Jhadeeee/Smart-Outlet-WebApp/README.md

# Smart-Outlet-WebApp
This is a web application project of smart outlet energy monitoring.
>>>>>>> 6da4d530e3375cbe3e670f05060c08142b17220a
