Jhadeeee/Smart-Outlet-WebApp/ISO25010_Questionnaire.pdf

# ISO 25010 Software Quality Evaluation Questionnaire

## Smart Outlet Web Application

## Home Appliances Load Monitoring System

### Based on ISO/IEC 25010:2023

### Systems and Software Quality Requirements and Evaluation (SQuaRE)

ISO 25010 Software Quality Evaluation - Smart Outlet Web Application

## Respondent Profile

Name (optional): | ___________________________________
Role: | End-User / Developer / IT Expert / Faculty-Evaluator
Age Range: | 18-25 / 26-35 / 36-45 / 46+
Technical Background: | Beginner / Intermediate / Advanced

## Rating Scale (5-Point Likert Scale)

Score | Interpretation

5 Strongly Agree

4 Agree

3 Neutral

2 Disagree

1 Strongly Disagree

## Part I: Product Quality (ISO 25010)

## 1. Functional Suitability

The degree to which the system provides functions that meet stated and implied needs.

# | Statement | 5 | 4 | 3 | 2 | 1

1.1 | The system accurately displays real-time current readings (mA) from smart outlets.
1.2 | The relay ON/OFF toggle controls work correctly and respond to user commands.
1.3 | The system correctly computes and displays the total load current from the main breaker sensor.
1.4 | The event history page allows users to view and filter past system events effectively.
1.5 | The system provides appropriate alerts/indicators for overload conditions.

## 2. Performance Efficiency

The performance relative to the amount of resources used under stated conditions.

# | Statement | 5 | 4 | 3 | 2 | 1

2.1 | The dashboard loads within an acceptable time (under 3 seconds).
2.2 | Real-time sensor data updates on the UI without noticeable delay.
2.3 | The live load history chart renders smoothly without lag.
2.4 | The system performs well even when multiple outlets are being monitored simultaneously.

## 3. Compatibility

The degree to which the system can exchange information with other systems and coexist in a shared environment.

# | Statement | 5 | 4 | 3 | 2 | 1

3.1 | The web application works correctly across different browsers (Chrome, Firefox, Edge, Safari).
3.2 | The system successfully communicates with the ESP32 (CCU) hardware over the local network.
3.3 | The Google Sheets integration exports data correctly and consistently.

## 4. Usability

The degree to which the system can be used by specified users to achieve goals effectively, efficiently, and with satisfaction.

# | Statement | 5 | 4 | 3 | 2 | 1

4.1 | The dashboard interface is visually appealing and easy to understand at first glance.
4.2 | Navigating between pages (Dashboard, Event History, AI Chatbot) is intuitive.
4.3 | The color-coded indicators (green, yellow, red) for load status are clear and informative.
4.4 | The expandable PIC cards make it easy to view and control individual outlet sockets.
4.5 | Error messages and toast notifications are clear and helpful.
4.6 | The system can be used with minimal training or prior technical knowledge.

## 5. Reliability

The degree to which the system performs specified functions under specified conditions for a specified period of time.

# | Statement | 5 | 4 | 3 | 2 | 1

5.1 | The system operates continuously without unexpected crashes or downtime.
5.2 | WebSocket connections for real-time updates reconnect automatically after disconnection.
5.3 | Sensor data is logged to the database reliably at the expected intervals.
5.4 | The system correctly recovers and displays the last known state when reopening a PIC card.

## 6. Security

The degree to which the system protects information and data from unauthorized access.

# | Statement | 5 | 4 | 3 | 2 | 1

6.1 | The login system effectively prevents unauthorized users from accessing the dashboard.
6.2 | User accounts and data are properly isolated (one user cannot access another's outlets).
6.3 | Sensitive actions (relay control, threshold setting) require authentication.
6.4 | The system uses secure communication protocols between the web app and hardware.

## 7. Maintainability

The degree of effectiveness and efficiency with which the system can be modified.

# | Statement | 5 | 4 | 3 | 2 | 1

7.1 | The codebase is well-organized and follows a clear project structure.
7.2 | New outlets or CCUs can be registered without modifying server code.
7.3 | The documentation is sufficient for a new developer to understand and maintain the project.

## 8. Portability

The degree to which the system can be transferred from one environment to another.

# | Statement | 5 | 4 | 3 | 2 | 1

8.1 | The web application is accessible from both desktop and mobile devices (responsive design).
8.2 | The system can be deployed on different hosting environments (local server, cloud).
8.3 | The application adapts properly to different screen sizes and orientations.

## Part II: Quality in Use (ISO 25010)

## 9. Effectiveness

Accuracy and completeness with which users achieve specified goals.

# | Statement | 5 | 4 | 3 | 2 | 1

9.1 | I was able to monitor my outlet power consumption accurately using the system.
9.2 | I was able to successfully control (turn on/off) outlet relays through the web interface.
9.3 | I was able to identify overload conditions and take appropriate action using the system.

## 10. Efficiency

Resources expended in relation to the accuracy and completeness of goals achieved.

# | Statement | 5 | 4 | 3 | 2 | 1

10.1 | I can complete common tasks (check status, toggle relays) quickly and with few steps.
10.2 | The system reduces the effort needed to monitor power usage compared to manual methods.

## 11. Satisfaction

The degree to which user needs are satisfied when using the system.

# | Statement | 5 | 4 | 3 | 2 | 1

11.1 | I am satisfied with the overall quality and appearance of the web application.
11.2 | I would recommend this system to others for home appliance load monitoring.
11.3 | The system meets my expectations for a smart outlet monitoring solution.

## 12. Safety / Freedom from Risk

The degree to which the system mitigates potential risk to users, property, or the environment.

# | Statement | 5 | 4 | 3 | 2 | 1

12.1 | The overload detection and alert system helps prevent potential electrical hazards.
12.2 | The "Cut All Power" emergency feature provides confidence in handling dangerous situations.
