Jhadeeee/Smart-Outlet-WebApp/Milestone/Central Control Unit dev/Documentation/CCU_Simulation_2.0.0.PDF

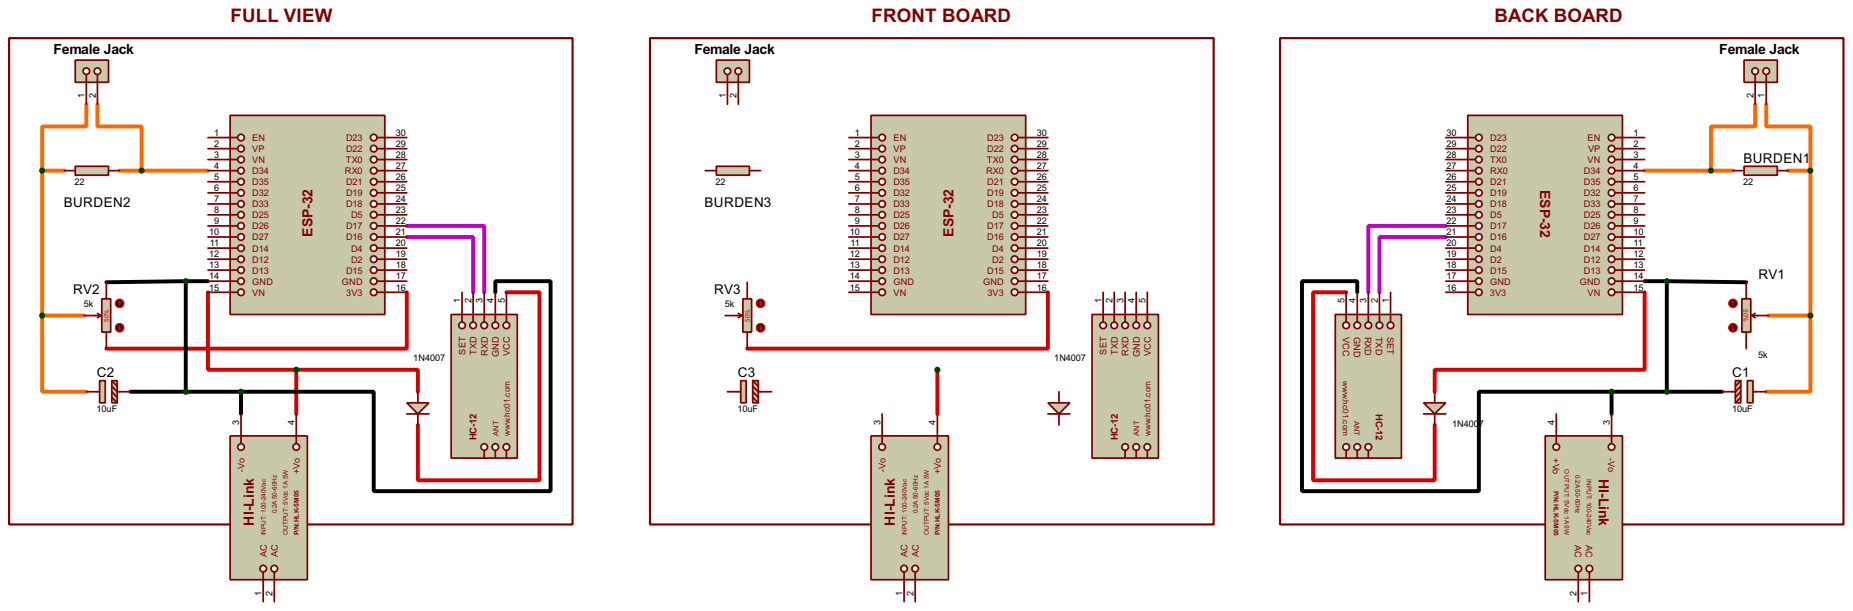
[picture p10: page 1]

ESP-32 ENVPVND35 D32 D33 D25 D26 D27 D14 D12 D13 GND VND34 D23 D22 TX0 RX0 D21 D19 D18D5 D17 D16D4D2 D15 GND 3V3 123456789101112131415 302928272625242322212019181716 HI-Link ACAC -Vo +Vo INPUT: 100-240Vac 0.2A 50-60Hz OUTPUT: 5Vdc 1A 5W P/N:HLK-5M05 12 34 SET TXD RXD GND VCC HC-12 ANT www.hc01.com 12345 BURDEN3 22 C3 10uF50% RV35k12 Female Jack FRONT BOARD 1N4007 ESP-32 ENVPVN D35 D32 D33 D25 D26 D27 D14 D12 D13 GNDVN D34 D23 D22 TX0 RX0 D21 D19 D18 D5D17 D16 D4D2D15 GND 3V3 123456789101112131415 302928272625242322212019181716 HI-Link ACAC -Vo +Vo INPUT: 100-240Vac 0.2A 50-60Hz OUTPUT: 5Vdc 1A 5W P/N:HLK-5M05 21 43 SET TXD RXD GND VCC HC-12 ANT www.hc01.com 54321 BURDEN1 22 C1 10uF50% RV1 5k 21 Female Jack BACK BOARD 1N4007 ESP-32 ENVPVND35 D32 D33 D25 D26 D27 D14 D12 D13 GND VND34 D23 D22 TX0 RX0 D21 D19 D18D5 D17 D16D4D2 D15 GND 3V3 123456789101112131415 302928272625242322212019181716 HI-Link ACAC -Vo +Vo INPUT: 100-240Vac 0.2A 50-60Hz OUTPUT: 5Vdc 1A 5W P/N:HLK-5M05 12 34 SET TXD RXD GND VCC HC-12 ANT www.hc01.com 12345 BURDEN2 22 C2 10uF50% RV25k12 Female Jack FULL VIEW 1N4007
