Jhadeeee/Smart-Outlet-WebApp/Milestone/Central Control Unit dev/Documentation/CCU_Simulation.PDF

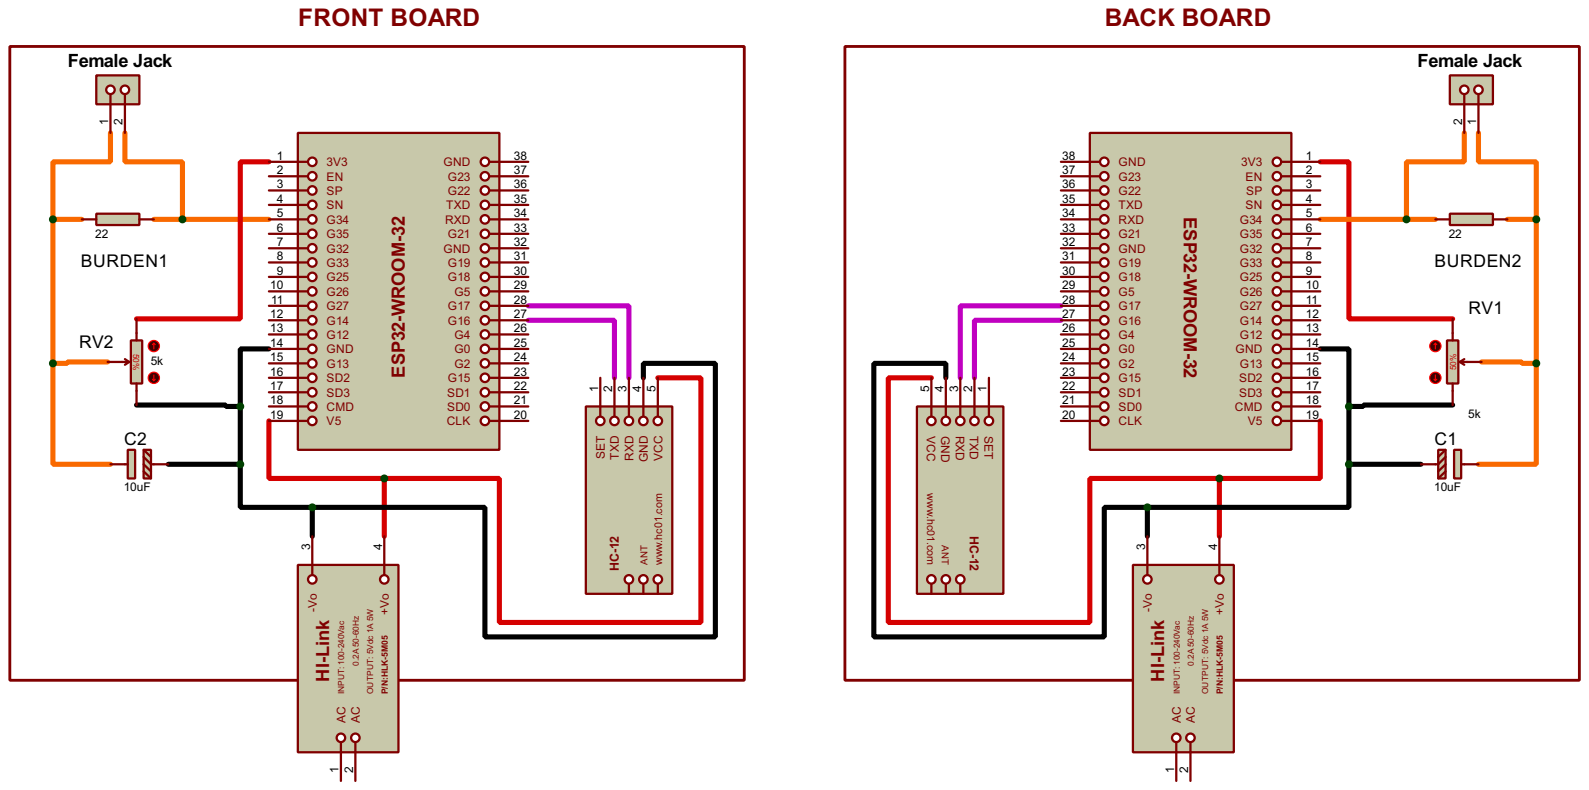
[picture p11: page 1]
