Jhadeeee/Smart-Outlet-WebApp/Milestone/Smart Outlet Device dev/Images/Smart outlet_Actual_Circuit_v5.2.0.PDF

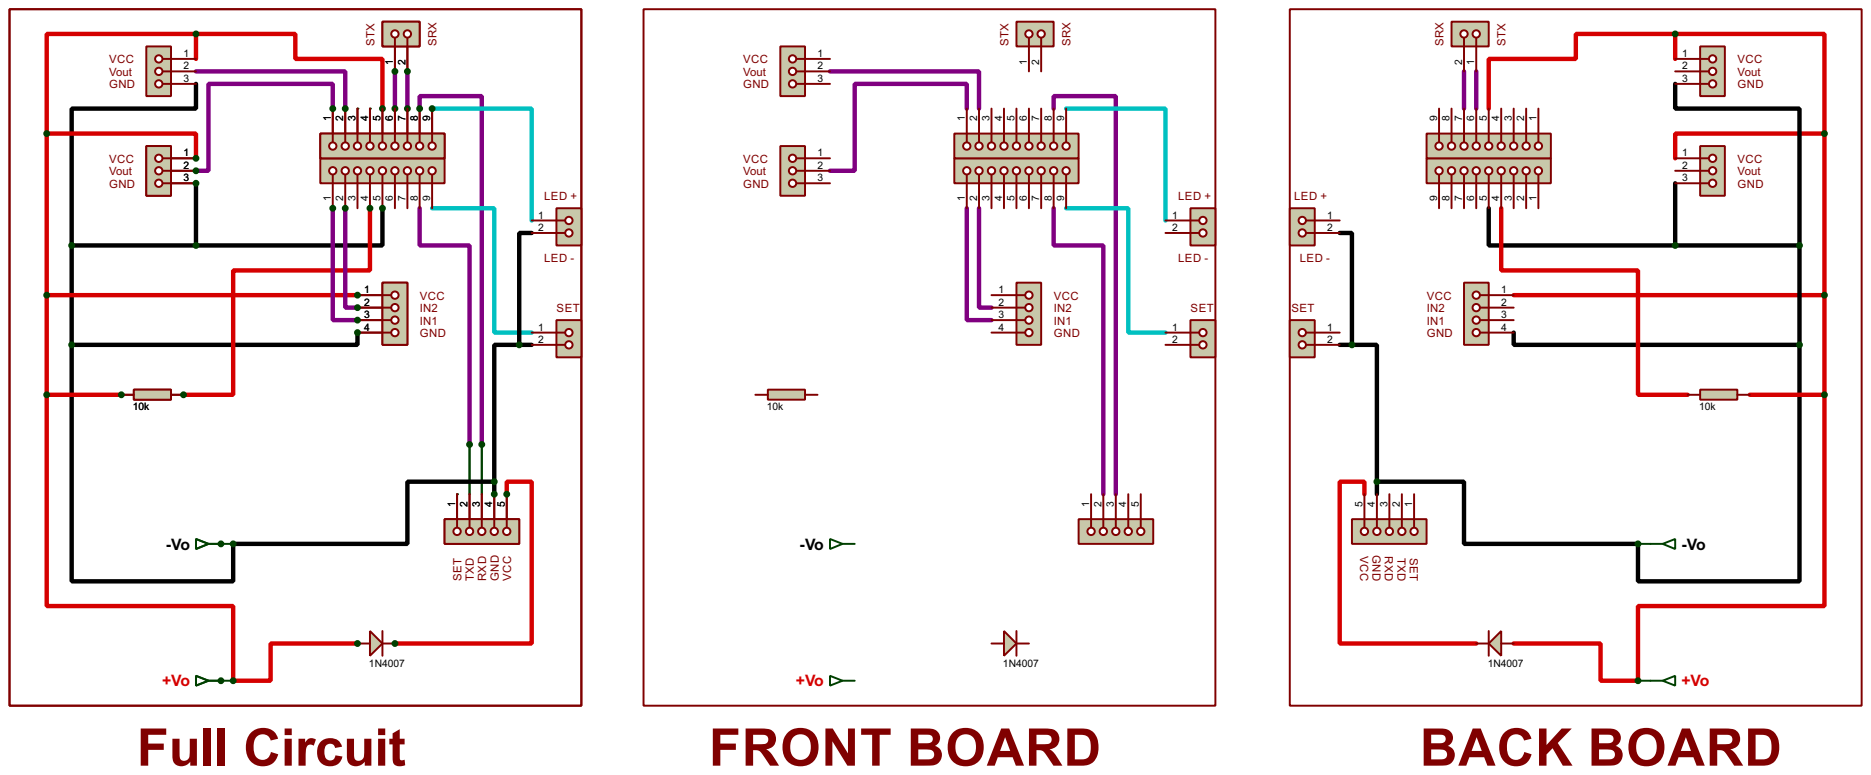
[picture p12: page 1]
