Jhadeeee/Smart-Outlet-WebApp/Central_Control_Unit_Firmware/Config.h

/*
 * Config.h
 * --------
 * Global configuration constants for the CCU Firmware v4.0.0.
 * Modify these values to match your hardware and preferences.
 */

#ifndef CONFIG_H
#define CONFIG_H

// ─── Access Point (Hotspot) Settings ────────────────────────
#define AP_SSID         "CCU-Setup"       // Name of the setup hotspot
#define AP_PASSWORD     ""                // Open network (no password)
#define AP_IP           IPAddress(192, 168, 4, 1)
#define AP_GATEWAY      IPAddress(192, 168, 4, 1)
#define AP_SUBNET       IPAddress(255, 255, 255, 0)

// ─── WiFi Connection Settings ───────────────────────────────
#define WIFI_CONNECT_TIMEOUT_MS   15000   // 15 seconds to attempt WiFi connection
#define WIFI_RETRY_DELAY_MS       500     // Delay between connection checks

// ─── Web Server ─────────────────────────────────────────────
#define WEB_SERVER_PORT  80

// ─── NVS Storage Keys ───────────────────────────────────────
#define NVS_NAMESPACE    "ccu-config"
#define NVS_KEY_SSID     "ssid"
#define NVS_KEY_PASSWORD "password"
#define NVS_KEY_SERVER   "serverUrl"

// ─── Hardware Pins ──────────────────────────────────────────
#define LED_PIN          2                // Built-in LED on most ESP32 boards
#define RESET_BTN_PIN    0                // BOOT button for factory reset

// ─── HC-12 RF Module ───────────────────────────────────────
#define HC12_RX_PIN      16               // ESP32 GPIO 16 ← HC-12 TX
#define HC12_TX_PIN      17               // ESP32 GPIO 17 → HC-12 RX
#define HC12_BAUD        9600             // HC-12 default baud rate

// ─── RF Protocol ────────────────────────────────────────────
#define RF_SOF           0xAA             // Start of Frame byte
#define RF_EOF           0xBB             // End of Frame byte
#define RF_PACKET_SIZE   8                // Fixed 8-byte packet size
#define CCU_SENDER_ID    0x02             // Non-default master ID — triggers LED on smart outlets
#define MAX_OUTLETS      8                // Maximum number of smart outlets

// ─── Breaker Monitor (SCT013) ───────────────────────────────
#define BREAKER_ADC_PIN              34   // ESP32 ADC pin (input-only, no pull-up)
#define BREAKER_CT_TURNS             2000 // SCT013-100 turns ratio
#define BREAKER_BURDEN_RESISTOR      23   // Burden resistor in Ohms
#define BREAKER_LINE_FREQ            60   // Mains frequency (50 or 60 Hz)
#define BREAKER_DEFAULT_THRESHOLD_MA 15000 // Default overload threshold (15A)
#define BREAKER_CLOUD_INTERVAL_MS    5000  // Send breaker data to cloud every 5s

// ─── Serial ─────────────────────────────────────────────────
#define SERIAL_BAUD      115200

// ─── Cloud / Server ─────────────────────────────────────────
#define CLOUD_SEND_INTERVAL_MS  2000      // How often to send data to server
#define HTTP_TIMEOUT_MS         5000      // HTTP request timeout
#define BACKGROUND_POLL_INTERVAL_MS  30000  // Poll non-focused outlets every 30s

#endif // CONFIG_H
