Jhadeeee/Smart-Outlet-WebApp/Central_Control_Unit_Firmware/src/WiFiServer/Cloud.cpp

/*
 * Cloud.cpp
 * ----------
 * Implementation of HTTP server communication.
 */

#include "Cloud.h"

Cloud::Cloud()
    : _serverUrl(""),
      _lastResponseCode(0),
      _lastResponse("") {}

void Cloud::begin(const String& serverUrl) {
    _serverUrl = serverUrl;

    // Ensure URL doesn't end with a trailing slash
    if (_serverUrl.endsWith("/")) {
        _serverUrl.remove(_serverUrl.length() - 1);
    }

    Serial.println("[Cloud] Initialized with server: " + _serverUrl);
}

int Cloud::sendSensorData(const String& jsonPayload) {
    if (_serverUrl.length() == 0 || WiFi.status() != WL_CONNECTED) {
        return -1;
    }

    HTTPClient http;
    String endpoint = _serverUrl + "/api/data/";
    
    http.begin(endpoint);
    http.addHeader("Content-Type", "application/json");
    http.setTimeout(HTTP_TIMEOUT_MS);

    _lastResponseCode = http.POST(jsonPayload);
    if (_lastResponseCode > 0) {
        _lastResponse = http.getString();
    } else {
        _lastResponse = http.errorToString(_lastResponseCode);
    }
    http.end();
    return _lastResponseCode;
}

int Cloud::sendBreakerData(const String& jsonPayload) {
    if (_serverUrl.length() == 0 || WiFi.status() != WL_CONNECTED) {
        return -1;
    }

    HTTPClient http;
    String endpoint = _serverUrl + "/api/breaker-data/";
    
    http.begin(endpoint);
    http.addHeader("Content-Type", "application/json");
    http.setTimeout(HTTP_TIMEOUT_MS);

    _lastResponseCode = http.POST(jsonPayload);
    if (_lastResponseCode > 0) {
        _lastResponse = http.getString();
    } else {
        _lastResponse = http.errorToString(_lastResponseCode);
    }
    http.end();
    return _lastResponseCode;
}

String Cloud::fetchCommands(const String& deviceId) {
    if (_serverUrl.length() == 0 || WiFi.status() != WL_CONNECTED) {
        return "";
    }

    HTTPClient http;
    String endpoint = _serverUrl + "/api/commands/" + deviceId + "/";
    
    http.begin(endpoint);
    http.setTimeout(HTTP_TIMEOUT_MS);

    _lastResponseCode = http.GET();
    String responseBody = "";
    
    if (_lastResponseCode == 200) {
        responseBody = http.getString();
    } else if (_lastResponseCode > 0) {
        _lastResponse = http.getString(); // Store error response
    } else {
        _lastResponse = http.errorToString(_lastResponseCode);
    }
    http.end();
    return responseBody;
}

String Cloud::fetchDevices() {
    if (_serverUrl.length() == 0 || WiFi.status() != WL_CONNECTED) {
        return "";
    }

    HTTPClient http;
    String endpoint = _serverUrl + "/api/devices/";
    
    http.begin(endpoint);
    http.setTimeout(HTTP_TIMEOUT_MS);

    _lastResponseCode = http.GET();
    String responseBody = "";
    
    if (_lastResponseCode == 200) {
        responseBody = http.getString();
    } else if (_lastResponseCode > 0) {
        _lastResponse = http.getString();
    } else {
        _lastResponse = http.errorToString(_lastResponseCode);
    }
    http.end();
    return responseBody;
}

String Cloud::fetchFocusDevice() {
    if (_serverUrl.length() == 0 || WiFi.status() != WL_CONNECTED) {
        return "";
    }

    HTTPClient http;
    String endpoint = _serverUrl + "/api/focus/";
    
    http.begin(endpoint);
    http.setTimeout(HTTP_TIMEOUT_MS);

    _lastResponseCode = http.GET();
    String responseBody = "";
    
    if (_lastResponseCode == 200) {
        responseBody = http.getString();
    } else if (_lastResponseCode > 0) {
        _lastResponse = http.getString();
    } else {
        _lastResponse = http.errorToString(_lastResponseCode);
    }
    http.end();
    return responseBody;
}

bool Cloud::isReachable() {
    if (_serverUrl.length() == 0 || WiFi.status() != WL_CONNECTED) {
        return false;
    }

    HTTPClient http;
    http.begin(_serverUrl);
    http.setTimeout(HTTP_TIMEOUT_MS);

    int code = http.GET();
    http.end();

    bool reachable = (code > 0);
    Serial.println("[Cloud] Server reachable: " + String(reachable ? "YES" : "NO"));
    return reachable;
}

String Cloud::getServerUrl() const       { return _serverUrl; }
int Cloud::getLastResponseCode() const   { return _lastResponseCode; }
String Cloud::getLastResponse() const    { return _lastResponse; }
