Jhadeeee/Smart-Outlet-WebApp/(commit log)

2026-02-22 feat: Add Smart Outlet firmware documentation, testing guide, ESP32 test sketch, and circuit diagram.
2026-02-23 chore: organize project workflow and restructure documentation
    - Add PROJECT_MILESTONES.md with system architecture, component status, and roadmap
    - Add CCU Firmware source code (ESP32 Arduino)
    - Add CCU developer documentation (FIRMWARE_DOCS.md, User_Testing_Guide.md)
    - Restructure Smart Outlet Device docs into Milestone/Documentation and Images folders
    - Fix broken documentation links in PROJECT_MILESTONES.md
    - Remove obsolete Smart Outlet firmware Documentation_v1.1.0 folder
    [CaptivePortal.cpp, CaptivePortal.h, Central_Control_Unit_Firmware.ino, Cloud.cpp, Cloud.h, Config.h, ConfigStorage.cpp, ConfigStorage.h]
2026-02-23 feat: Introduce firmware-aligned data models, API endpoints for sensor data and commands, and real-time WebSocket updates.
2026-02-23 feat: Establish firmware-to-web communication for sensor data and commands, and add web app user authentication and outlet control dashboard.
2026-02-23 feat: Implement core Central Control Unit firmware for current sensing and cloud communication, and establish Django models and API for smart outlet management.
2026-02-23 feat: Implement real-time sensor data and relay control via WebSockets, along with user authentication and dashboard views.
2026-02-24 feat: Implement core smart outlet backend with device API endpoints, data models, and web views.
2026-02-24 feat: complete testing dashboard UI and command queue API
    - Wired Set Limit and Cut Power buttons to fetch API
    - Replaced native confirm with Tailwind modals for reliability
    - Mapped SET_MASTER_ID event correctly in views.py
    - Updated milestone documentation for backend completion
    [Central_Control_Unit_Firmware.ino]
2026-02-24 feat: Adjust database schema by removing `SensorData` fields and manually creating the `PendingCommand` table, alongside adding database probing tools.
2026-02-24 feat: implement 2-way command polling on ESP32 CCU
    - Added fetch_pending_commands GET endpoint to Django views
    - Added fetchCommands() method to ESP32 Cloud library
    - CCU main loop now parses CMD_CUT_POWER, CMD_SET_LIMIT from JSON
    - Updated Verification Plan to include Captive Portal step
2026-02-24 Fix database schema for PendingCommand and ESP32 JSON casing
2026-02-24 Fix dashboard add device automatic DB insertion update
    [Central_Control_Unit_Firmware.ino, Cloud.cpp]
2026-02-24 Replace browser prompt with a Tailwind UI modal for adding devices
2026-02-25 feat: Implement core API endpoints for sensor data, breaker data, outlet status, and command queuing, alongside initial Central Control Unit firmware structure.
2026-02-25 docs: Add web app documentation, user setup guide, and update project milestones
    - Created WEBAPP_DOCS.md with architecture, models, API reference, data flow, WebSocket, and alert system
    - Created User_Setup_Guide.md with step-by-step setup, ESP32 connection, and troubleshooting
    - Updated PROJECT_MILESTONES.md: Web app status to v1.0.0 Stable, added 11 milestone entries
    - Updated roadmap: checked off cloud integration, dashboard, auto-registration, and alert system
    - Added documentation index links for both new docs
    - Fixed firmware: dynamic is_overload flag (was hardcoded false)
    - Fixed firmware: auto device registration from Django on boot and periodic re-sync
2026-02-25 Replace SCTSensor with BreakerMonitor (non-blocking)
    - Deleted src/SCTSensor/ — duplicate blocking sensor module
    - Restored BREAKER_* constants in Config.h (replaces SCT_* raw ADC approach)
    - Rewired main sketch to use BreakerMonitor (non-blocking update + getMilliAmps)
    - Fixed Dashboard constructor to pass BreakerMonitor reference
    - Added breakerMonitor.begin() in LOCAL_DASHBOARD and RUNNING mode entries
    - Added breakerMonitor.update() in both loop modes
    - Cloud push now uses breakerMonitor.getMilliAmps() instead of blocking readCurrentRMS()
    - Bumped firmware version to v4.0.0
    [Central_Control_Unit_Firmware.ino, Config.h]
2026-02-26 Updated Circuit diagram
2026-02-26 added .workspace on gitignore and updated circuit diagram
2026-02-26 Remove SCTSensor module — use BreakerMonitor exclusively
    - Deleted src/SCTSensor/ (blocking, redundant with BreakerMonitor)
    - Removed SCT_* derived constants from Config.h
    - Added BREAKER_CLOUD_INTERVAL_MS (5s breaker cloud push interval)
    - Jhade's .ino already uses BreakerMonitor correctly — no changes needed
    [Config.h]
2026-02-27 Fix overload logging, UI delay, and sensor data log interval
    - Moved breaker polling to an independent timer in firmware to eliminate total load current UI delay (Config.h, Central_Control_Unit_Firmware.ino)
    - Fixed firmware parser bug in OutletManager.cpp to correctly save and report 0xFFFF overload trips to the backend
    - Decreased DB_LOG_INTERVAL from 5 minutes to 30 seconds in api/views.py for faster history logging
    [Central_Control_Unit_Firmware.ino, Config.h, OutletManager.cpp]
2026-03-03 feat: Fix 65535mA display issue to OVERLOAD and set 1 minute every log of outlets_sensordata instead of 30s.
2026-03-03 Display current in mA instead of A (no rounding)
    - views.py: pass raw mA values instead of converting to Amps
    - home.html: show mA unit in static template and WebSocket updates
    - Subtitle shows total mA instead of rounded A
2026-03-03 Direct ESP32 communication + clean serial output
    - Django: Add ip_address, last_seen to CentralControlUnit model
    - Django: Add ccu FK to Outlet (auto-linked on sensor push)
    - Django: Add missing EventLog model (from Jhade merge)
    - Django: Capture ESP32 IP in sensor/breaker endpoints
    - Django: Direct HTTP relay via ESP32 with PendingCommand fallback
    - ESP32: Add /api/ext/relay, /api/ext/threshold, /api/ext/ping routes
    - ESP32: Clean [LIVE] single-line serial output per device per cycle
    - Frontend: Toggle loading state with revert on failure
    - Migrations: Merge 0008 + new fields in 0009
    [Central_Control_Unit_Firmware.ino, Dashboard.cpp, Dashboard.h]
2026-03-03 Add [LIVE] serial output to LOCAL_DASHBOARD mode too
    Same compact format prints every 2s even without WiFi/cloud
2026-03-03 Event-driven serial output with device names
    - [RX PACKET] RAW: ... | FROM: 0x03 | TYPE: DATA REPORT (98mA)
    - [PIC 3] Breaker: 256mA | 0x03: A=98mA B=98mA | RA: OFF RB: ON
    - Silent when idle, prints only when data arrives
    - Works in both LOCAL_DASHBOARD and RUNNING modes
    - Added breaker cache to OutletManager for status lines
2026-03-03 Update docs: v4.1.0 CCU + v1.2.0 WebApp milestones
    - PROJECT_MILESTONES: new entries, version bumps, roadmap checkboxes
    - FIRMWARE_DOCS: external API routes, serial format, breaker cache API
    - WEBAPP_DOCS: EventLog model, IP tracking, direct communication flow, toggle loading
2026-03-03 Add Quick Start Guide to WEBAPP_DOCS
    - Server startup/kill commands with venv path
    - PC IP lookup for ESP32 setup
    - ESP32 WiFi configuration steps
    - Database migration commands
    - Common commands reference table
2026-03-03 Fix breaker ghost reading + empty device names in RUNNING mode
    - Auto-tare SCT013 after begin() in both LOCAL_DASHBOARD and RUNNING
    (WiFi STA shifts ESP32 ADC DC offset, causing ~9400mA ghost reading)
    - Auto-name devices as 'PIC X' on creation in _addDevice()
    (fixes empty [] in serial output when devices come from cloud sync)
    [Central_Control_Unit_Firmware.ino, OutletManager.cpp]
2026-03-03 Implement Focus Device feature — mirrors local dashboard behavior
    Django:
    - Added focused_device field to CentralControlUnit
    - 3 new API endpoints: GET/POST /api/focus/, POST /api/focus/clear/
    - Migration 0010 applied
    ESP32:
    - Added Cloud::fetchFocusDevice() — polls /api/focus/
    - Cloud loop only reads sensors for the focused device
    - Breaker always sends every 2s cycle (same speed as sensors)
    Web UI:
    - Outlet cards start collapsed (dimmed, body hidden)
    - Click header to expand — posts to /api/focus/<id>/
    - Only one card expanded at a time (last-write-wins)
    - Collapsed: 0mA, disabled toggles, controls hidden
    - Expanded: live data, enabled toggles, smooth animation
    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
2026-03-03 docs: Update milestones for Focus Device — CCU v4.2.0 / WebApp v1.3.0
    PROJECT_MILESTONES.md:
    - Bumped CCU to v4.2.0, WebApp to v1.3.0
    - New milestone entries for Focus Device feature
    - Marked roadmap item complete
    FIRMWARE_DOCS.md:
    - Bumped to v4.2.0
    - Added Focus Device to RUNNING mode (polls /api/focus/)
    - Fixed cloud push interval: 10s → 2s
    WEBAPP_DOCS.md:
    - Bumped to v1.3.0
    - Added focused_device field to CentralControlUnit table
    - Added Focus Device API reference (GET/POST /api/focus/)
    - Added Focus Device + Last-write-wins edge cases
2026-03-03 fix: Breaker serial output showing inflated values
    Root cause: _lastBreakerMA cache was being updated every loop
    iteration. breakerMonitor.hasReading() returns true forever after
    first reading, so the cache was always written with getMilliAmps().
    But getMilliAmps() returns the last completed 10-cycle RMS reading,
    and WiFi activity injects ADC noise that inflates the RMS sum.
    Fix: Only update the cache when breakerMonitor.update() returns true
    (a complete 10-cycle RMS measurement finished). This ensures the
    serial output matches the dashboard's stable readings.
    Before: Breaker: 2310mA (serial) vs 1.20A=1200mA (dashboard)
    After: Both show ~1200mA consistently
    [Central_Control_Unit_Firmware.ino]
2026-03-03 fix: Apply EMA smoothing to breaker readings (serial + cloud)
    ESP32 WiFi causes ADC noise spikes that inflate SCT013 RMS readings.
    Applied exponential moving average smoothing to both LOCAL_DASHBOARD
    and RUNNING modes:
    - Normal: 80% old + 20% new (smooth transitions)
    - Spike filter: if raw > 3x or < 1/3 of previous, use 95/5 weighting
    - First reading: use raw value
    Both serial output and cloud-sent breaker data now use smoothed
    values, matching the stable behavior the local dashboard displays.
    [Central_Control_Unit_Firmware.ino]
2026-03-03 fix: Serial breaker reads DIRECTLY from BreakerMonitor (like dashboard)
    Root cause: serial output used a stale _lastBreakerMA cache that
    picked up WiFi-corrupted readings. The local dashboard reads
    _breaker.getAmps() directly via its API handler and shows correct
    values.
    Fix: Replaced _lastBreakerMA cache with a BreakerMonitor* pointer.
    - OutletManager._parsePacket() now calls getLiveBreakerMA() which
    reads _breakerMonitor->getMilliAmps() directly
    - Exactly the same source as Dashboard::_handleApiBreakerStatus()
    - Removed all EMA smoothing (no longer needed)
    - Cloud payload also sends breakerMonitor.getMilliAmps() directly
    - setBreakerMonitor() called in both enterLocalDashboard/RunningMo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
    [Central_Control_Unit_Firmware.ino, OutletManager.cpp, OutletManager.h]
2026-03-03 fix: Reorder loop — breakerMonitor.update() AFTER serial print
    Root cause: breakerMonitor.update() was called BETWEEN dashboard.handleClient()
    and outletManager.update(). When update() completed a new RMS reading (noisy
    from WiFi AP beacons), it changed _lastAmps. The dashboard had already read the
    PREVIOUS clean value, but serial then read the NEW noisy value.
    Fix: Move breakerMonitor.update() AFTER outletManager.update() so both
    dashboard API and serial print read the same _lastAmps (from previous cycle).
    Before: dashboard reads 1.20A → update() sets 3.57A → serial reads 3.57A ✗
    After: dashboard reads 1.20A → serial reads 1.20A → update() sets new value ✓
    [Central_Control_Unit_Firmware.ino]
2026-03-03 fix: Use BLOCKING breaker reads — tight 166ms ADC burst immune to WiFi
    Root cause finally identified: the non-blocking update() takes ONE ADC
    sample per loop iteration with huge gaps between samples. During those
    gaps, ESP32 WiFi AP beacon transmissions corrupt the ADC. The blocking
    readAmps() does a tight continuous 166ms sampling burst — thousands of
    back-to-back reads with no WiFi gaps — producing clean RMS values.
    This is exactly how the local dashboard gets clean values: it polls
    the API which reads _lastAmps, and at that moment the value was set
    by a clean measurement cycle.
    Changes:
    - BreakerMonitor: added readFresh() — calls blocking _sensor.readAmps()
    - LOCAL_DASHBOARD loo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
    [BreakerMonitor.cpp, BreakerMonitor.h, Central_Control_Unit_Firmware.ino]
2026-03-03 sync: Replace all files with Ranian_dev branch contents
    [Cloud.cpp, Cloud.h, Config.h, Dashboard.cpp, Dashboard.h]
2026-03-03 fix: Apply blocking readFresh() to RUNNING mode too
    Same fix as LOCAL_DASHBOARD: replaces noisy non-blocking
    breakerMonitor.update() with periodic readFresh() every 1.5s.
    This ensures both serial output AND cloud-sent breaker data
    use clean 166ms blocking ADC reads in RUNNING mode.
    [Central_Control_Unit_Firmware.ino]
2026-03-03 docs: Update milestones for Breaker ADC Fix — CCU v4.3.0
    - PROJECT_MILESTONES.md: bumped CCU/Breaker to v4.3.0, added milestone entry
    - FIRMWARE_DOCS.md: updated loop descriptions (readFresh vs update),
    added readFresh() to BreakerMonitor API, replaced setLastBreakerMA
    with setBreakerMonitor/getLiveBreakerMA, fixed cloud interval 10s->2s
    - WEBAPP_DOCS.md: no changes needed (breaker fix was firmware-only)
2026-03-04 feat: Background polling for all outlets + real-time UI updates
    - Add background round-robin polling for non-expanded outlets (every 30s)
    - All registered outlets now log sensor data to DB even when not focused
    - WebSocket updates now show live current on collapsed outlet cards
    - Active/Inactive status badges update in real-time without page refresh
    - Collapsing a card preserves its last known current reading
    - Add BACKGROUND_POLL_INTERVAL_MS (30s) to Config.h
    - Background-polled devices also fetch and execute pending commands
2026-03-04 feat: Dashboard enhancements — breaker monitor, event history, noise filters
    - Expandable Total Load card with color indicators (green/yellow/red based on threshold %)
    - Active outlet list inside breaker panel with per-device Cut button
    - Cut All Power button moved inside expandable breaker card
    - Sensor noise floor filter: 0-100mA clamped to 0 (PIC baseline noise)
    - Breaker noise floor filter: 0-250mA clamped to 0 (SCT-013 baseline noise)
    - Active/Inactive badges update in real-time via WebSocket
    - Event History page with card and table view modes
    - Event type filters: All, Overload, Threshold, Relay, Server
    - Event History link added to profile dropdown menu
    - Theme matched across dashbo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
2026-03-04 docs: Update Milestone documentation for v7.0.0
    - Updated PROJECT_MILESTONES.md with v7.0.0 WebApp and v5.0.0 CCU entries
    - Added roadmap items: breaker monitor, noise filters, event history, real-time badges
    - Updated WEBAPP_DOCS.md with proper server run flow (.venv activation + runserver)
    - Added noise floor filter documentation (outlet 0-100mA, breaker 0-250mA)
    - Added Event History page and Breaker Monitor Panel sections
    - Updated DB intervals (60s sensor, 5min breaker) and configuration constants
    - Updated User_Setup_Guide.md with correct venv activation steps
    - Updated CCU FIRMWARE_DOCS.md with v5.0.0, Huge APP partition scheme details
2026-03-04 docs: Update Milestone documentation for v7.1.0
    - Rewrote User_Testing_Guide.md with accurate v5.0.0 UI details and embedded screenshots
    - Resized all images in User_Testing_Guide.md using HTML img tags (width=300)
    - Added Circuit Simulation section to FIRMWARE_DOCS.md with link to CCU_Simulation_2.0.0.PDF
    - Fixed kill-server PowerShell command in WEBAPP_DOCS.md (ForEach-Object pipeline)
2026-03-04 Add Google Sheets integration and clamp negative sensor values
    - Add threshold field to MainBreakerReading model
    - Add /api/export/sheets/ endpoint for Google Sheets data export
    - Add SHEETS_API_KEY setting for API key protection
    - Create Google Apps Script for auto-syncing sensor data to Google Sheets
    - Add 4 separate sheets: Outlet 1 (0xFE), Outlet 2 (0x02), Outlet 3 (0x03), Main Breaker
    - Auto-refresh trigger every 1 minute via Apps Script
    - Clamp negative sensor readings to 0 for outlets and breaker data
2026-03-04 feat: WiFi Scanner UI, Server URL auto-formatting, and v8.0.0 docs
    - Updated PROJECT_MILESTONES.md with v8.0.0 WebApp and v8.0.0 CCU entries
    - Added WiFi Scanner UI to CCU Captive Portal and Dashboard Settings
    - Added Server URL auto-formatting logic (auto-prepends http://) to CCU
    - Replaced cc_url input types from url to text to allow bare IPs
    - Replaced Setup page screenshots with a 4-step process visual gallery in User_Testing_Guide.md
    - Updated CCU FIRMWARE_DOCS.md to document the Server URL auto-formatting
    - Bumped WEBAPP_DOCS.md version to v8.0.0
    - Updated User_Setup_Guide.md with v8.0.0+ ESP32 CCU Firmware requirement
    [CaptivePortal.cpp, CaptivePortal.h, Dashboard.cpp, Dashboard.h]
2026-03-05 feat: Live breaker chart + card state cache + noise floor update
    - Added live line graph for total load current (Chart.js)
    - Purple gradient chart with 60-point rolling window inside breaker panel
    - Real-time data push from breaker WebSocket to chart
    - Card state persistence: re-expanding a card instantly restores last known readings
    - Toggle switches preserve visual state when card is collapsed
    - Breaker noise floor increased from 250 mA to 280 mA
2026-03-05 docs: Update Milestone documentation for v8.1.0 — WebApp v8.1.0
    - Added v8.1.0 WebApp milestone entry for live breaker chart, card caching, noise floor update
    - Updated BREAKER_NOISE_FLOOR_MA from 250 to 280 in WEBAPP_DOCS.md (3 places)
    - Added live line chart (Chart.js) and card state caching to Breaker Monitor Panel docs
    - Updated roadmap noise floor from 0-250mA to 0-280mA in PROJECT_MILESTONES.md
2026-03-05 feat: Breaker threshold persistence + live chart + card cache
    - Added breaker_threshold field to CentralControlUnit model (migration 0012)
    - Moved threshold storage from MainBreakerReading rows to CCU config
    - API endpoint POST /api/breaker-threshold/ saves to CentralControlUnit
    - receive_breaker_data stamps CCU threshold on each new reading for spreadsheet
    - Live Chart.js line graph for total load current in breaker panel
    - Card state caching: re-expanding PIC cards instantly restores last known state
    - Input and JS variable load saved threshold from database on page load
    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
2026-03-07 feat: Smart Outlet LED activation + roadmap update
    - Changed CCU_SENDER_ID from 0x01 to 0x02 in Config.h to trigger LED on smart outlets
    - Removed unimplemented Global Master ID input and Set (Hold PIC 3s) button from CCU card
    - Removed placeholder setMasterId() JS function from home.html
    - Added Development Roadmap v9.0.0 with 6 prioritized features to PROJECT_MILESTONES.md
    - Updated completed milestones list with recent achievements (chart, threshold, Sheets integration)
2026-03-07 feat: Render deployment complete
    - Successful hosting on Render (https://smart-outlet-webapp.onrender.com)
    - Changed ngrok URL to Render URL in google_apps_script.js
    - Updated roadmap: marked Priority 1 (LED) and Priority 4 (Render) as done
